thaeds/BalanceBot/sandbox/dxl_hal.c

// Dynamixel SDK platform dependent source
#include "dxl_hal.h"


int dxl_hal_open( int devIndex, float baudrate )
{
	// Opening device
	// devIndex: Device index
	// baudrate: Real baudrate (ex> 115200, 57600, 38400...)
	// Return: 0(Failed), 1(Succeed)
	return 1;
}

void dxl_hal_close()
{
	// Closing device

}

void dxl_hal_clear(void)
{
	// Clear communication buffer

}

int dxl_hal_tx( unsigned char *pPacket, int numPacket )
{
	// Transmiting date
	// *pPacket: data array pointer
	// numPacket: number of data array
	// Return: number of data transmitted. -1 is error.
	return 0;
}

int dxl_hal_rx( unsigned char *pPacket, int numPacket )
{
	// Recieving date
	// *pPacket: data array pointer
	// numPacket: number of data array
	// Return: number of data recieved. -1 is error.
	return 0;
}

void dxl_hal_set_timeout( int NumRcvByte )
{
	// Start stop watch
	// NumRcvByte: number of recieving data(to calculate maximum waiting time)

}

int dxl_hal_timeout(void)
{
	// Check timeout
	// Return: 0 is false, 1 is true(timeout occurred)
	return 0;
}
