thaeds/BalanceBot/(commit log)

2016-04-13 Moved arduino code to organize ros build space
2016-04-13 Removed old arduino code to organize ros build space
2016-04-17 Motors 1 and 2 move in series, need to fix tilt.yaml to support multiple motors simultaeously OMGAMAZING
    [main.cpp]
